Atmega328PP/5V-MAX-V-CPLD-breakout/Bill of Materials.txt

Bill of Materials:
MAX V 5M40Z EQFP 5V breakout board materials

Supplier links provided will all be Digikey (with minor exceptions), do note however that other suppliers may have better deals

All unit prices are from the given supplier at the date of BOM creation (12/01/2025)

Level shifters:

TXS0108EPWR
	Quantity: 6
	Digikey link: https://www.digikey.com/en/products/detail/texas-instruments/TXS0108EPWR/1775302
	Current unit price:	1.52 USD
	Current price to order 6 units: 9.12 USD
	Notes: You could buy 10 from digikey for 11.08 USD currently

CPLD:

5M40ZE64C5N
	Quantity: 1
	Digikey link: https://www.digikey.com/en/products/detail/altera/5M40ZE64C5N/2499440
	Current unit price: 1.26 USD
	Notes: All MAX V 5M40Z CPLDs are electrically pin swappable and each can be subtituted for one another

Voltage Converters:

TPSM828212 (5v to 1.8v)
	Quantity: 1
	Digikey link: https://www.digikey.com/en/products/detail/texas-instruments/TPSM828212SILR/14124028
	Current unit price: 2.61 USD

TPSM828214SILR (5v to 3.3v)
	Quantity: 1
	Digikey link: https://www.digikey.com/en/products/detail/texas-instruments/TPSM828214SILR/14124001
	Current unit price: 2.61 USD

JTAG header:

Generic 5x2 IDC male header
	Quantity: 1
	Digikey link: https://www.digikey.com/en/products/detail/on-shore-technology-inc/302-S101/2178422
	Current unit price: 0.26 USD

Board primary headers:

	Generic 1x27 2.54mm pitch male headers
	Quantity: 2
	Amazon link: https://www.amazon.com/Pin-Header-Connector-Breadboard-Connectors/dp/B0DSJD6TDR
	Current price for pack of 12 40 pin headers: 4.39 USD
	Notes: This is obviously VERY generic, and these headers can be broken into the ideal size, so I recommend that you find the best deal for a pack of them.

Capacitors:

10μF 0805:
	Quantity: 1
	Digikey link: https://www.digikey.com/en/products/detail/samsung-electro-mechanics/CL21A106KOQNNNE/3886754
	Current unit price: 0.08 USD

.01μF 0805:
	Quantity: 20
	Digikey link: https://www.digikey.com/en/products/detail/yageo/CC0805KRX7R9BB104/302874
	Current unit price: 0.08 USD
	Current price to order 20 units in cut-tape: 0.24 USD
	Notes: Ordering more than 10 reduces unit price to 0.012 USD

Resistors:

10kΩ 0805:
	Quantity: 2
	Digikey link: https://www.digikey.com/en/products/detail/vishay-dale/CRCW080510K0FKEA/1175751
	Current unit price: 0.1 USD
	Current price to order 2 units: 0.2 USD

1kΩ 0805:
	Quantity: 1
	Digikey link: https://www.digikey.com/en/products/detail/vishay-dale/CRCW08051K00FKEA/1175637
	Current unit price 0.1 USD
	
Total approximate price:

	16.48 USD excluding primary headers
	18.2 USD including male headers
	25-47 USD including PCB manufacturing (HIGHLY DEPENDANT ON MANUFACTURER)
