Atmega328PP/5V-MAX-V-CPLD-breakout/KiCAD files/CPLD breakout.kicad_pcb

## KiCad design KiCAD files/CPLD breakout.kicad_pcb (2025-12-01)

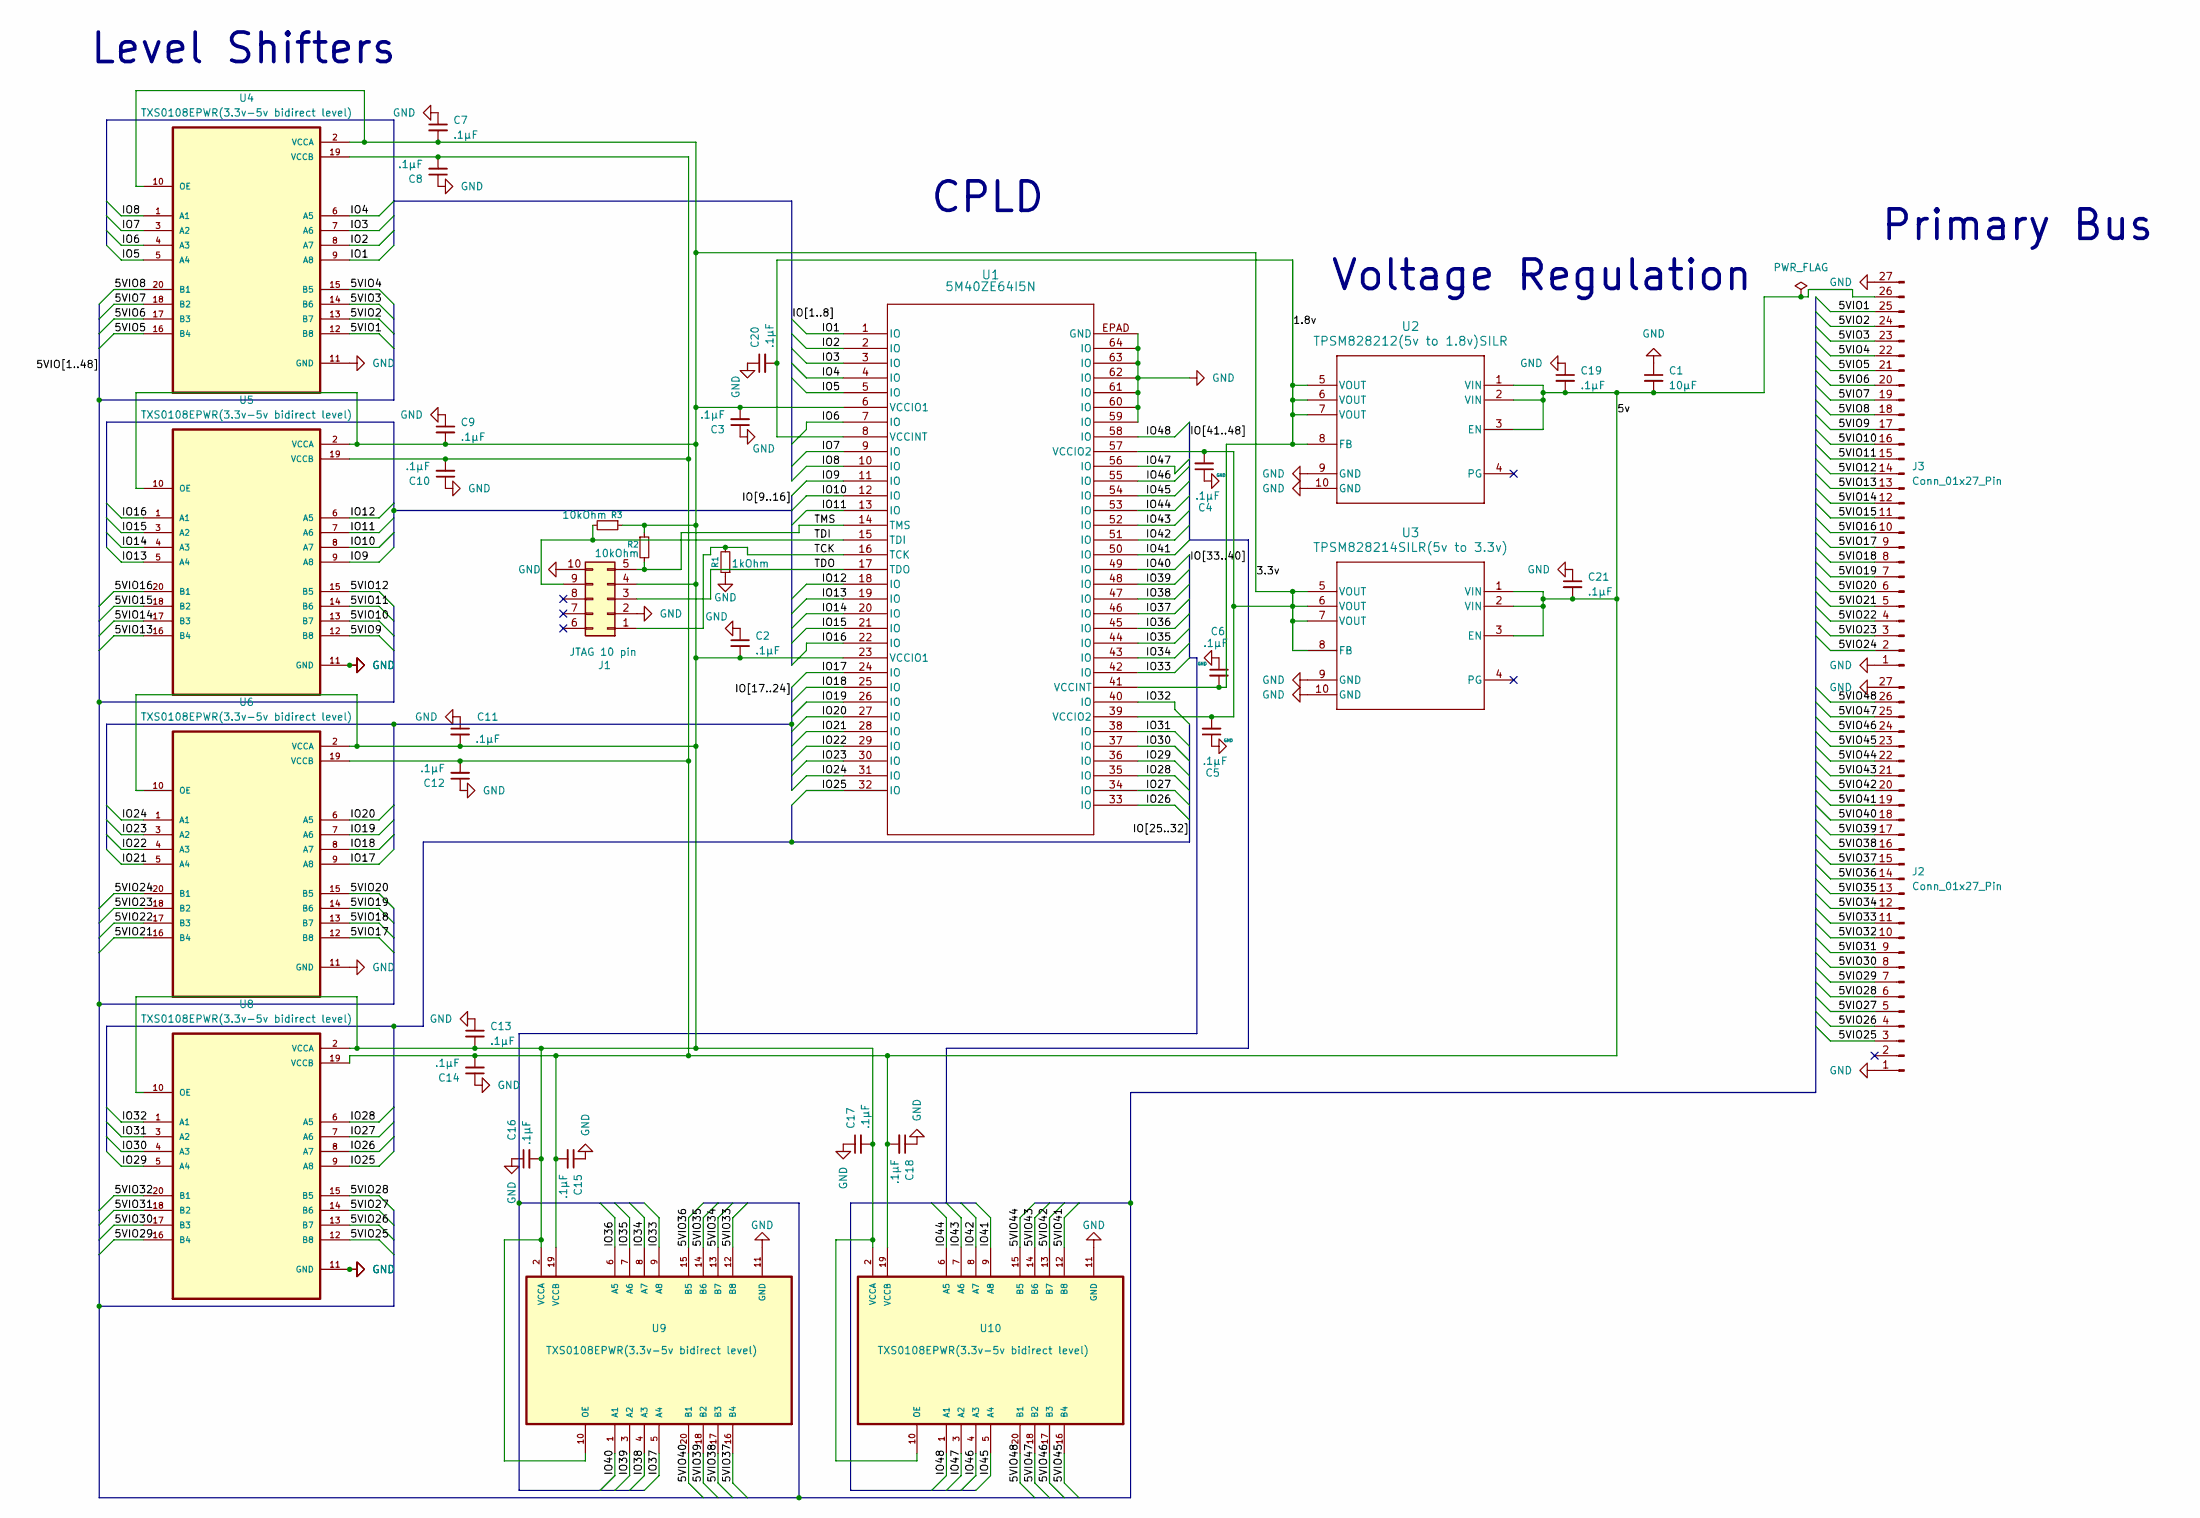
[picture p1: schematic CPLD breakout.kicad_sch, Altera CPLD 5M40Z 5v breakout]

Parts:
C1: 10μF; C_0805_2012Metric
C2, C3, C4, C5, C6, C7, C8, C9, C10, C11, C12, C13, C14, C15, C16, C17, C18, C19, C20, C21: .1μF; C_0805_2012Metric
J1: JTAG 10 pin; IDC-Header_2x05_P2.54mm_Vertical
J2, J3: Conn_01x27_Pin; PinHeader_1x27_P2.54mm_Vertical
R1: 1kOhm; R_0805_2012Metric
R2, R3: 10kOhm; R_0805_2012Metric
U1: 5M40ZE64I5N; EQFP64_A_1P2-D2_4P5_INT
U2: TPSM828212(5v to 1.8v)SILR; TPSM828212SILR(5v to 1.8v)
U3: TPSM828214SILR(5v to 3.3v)
U4, U5, U6, U8, U9, U10: TXS0108EPWR(3.3v-5v bidirect level); SOP65P640X120-20N(3.3v-5v bidirect shift)

Connections:
/1.8v: C6.2, C20.2, U1.8 (VCCINT), U1.41 (VCCINT), U2.5 (VOUT), U2.6 (VOUT), U2.7 (VOUT), U2.8 (FB)
/3.3v: C2.2, C3.2, C4.2, C5.2, C7.2, C9.2, C11.2, C13.2, C16.2, C17.2, J1.4, R2.1, R3.1, U1.6 (VCCIO1), U1.23 (VCCIO1), U1.39 (VCCIO2), U1.57 (VCCIO2), U3.5 (VOUT), U3.6 (VOUT), U3.7 (VOUT), U3.8 (FB), U4.2 (VCCA), U4.10 (OE), U5.2 (VCCA), U5.10 (OE), U6.2 (VCCA), U6.10 (OE), U8.2 (VCCA), U8.10 (OE), U9.2 (VCCA), U9.10 (OE), U10.2 (VCCA), U10.10 (OE)
/5VIO1: J3.25, U4.12 (B8)
/5VIO2: J3.24, U4.13 (B7)
/5VIO3: J3.23, U4.14 (B6)
/5VIO4: J3.22, U4.15 (B5)
/5VIO5: J3.21, U4.16 (B4)
/5VIO6: J3.20, U4.17 (B3)
/5VIO7: J3.19, U4.18 (B2)
/5VIO8: J3.18, U4.20 (B1)
/5VIO9: J3.17, U5.12 (B8)
/5VIO10: J3.16, U5.13 (B7)
/5VIO11: J3.15, U5.14 (B6)
/5VIO12: J3.14, U5.15 (B5)
/5VIO13: J3.13, U5.16 (B4)
/5VIO14: J3.12, U5.17 (B3)
/5VIO15: J3.11, U5.18 (B2)
/5VIO16: J3.10, U5.20 (B1)
/5VIO17: J3.9, U6.12 (B8)
/5VIO18: J3.8, U6.13 (B7)
/5VIO19: J3.7, U6.14 (B6)
/5VIO20: J3.6, U6.15 (B5)
/5VIO21: J3.5, U6.16 (B4)
/5VIO22: J3.4, U6.17 (B3)
/5VIO23: J3.3, U6.18 (B2)
/5VIO24: J3.2, U6.20 (B1)
/5VIO25: J2.3, U8.12 (B8)
/5VIO26: J2.4, U8.13 (B7)
/5VIO27: J2.5, U8.14 (B6)
/5VIO28: J2.6, U8.15 (B5)
/5VIO29: J2.7, U8.16 (B4)
/5VIO30: J2.8, U8.17 (B3)
/5VIO31: J2.9, U8.18 (B2)
/5VIO32: J2.10, U8.20 (B1)
/5VIO33: J2.11, U9.12 (B8)
/5VIO34: J2.12, U9.13 (B7)
/5VIO35: J2.13, U9.14 (B6)
/5VIO36: J2.14, U9.15 (B5)
/5VIO37: J2.15, U9.16 (B4)
/5VIO38: J2.16, U9.17 (B3)
/5VIO39: J2.17, U9.18 (B2)
/5VIO40: J2.18, U9.20 (B1)
/5VIO41: J2.19, U10.12 (B8)
/5VIO42: J2.20, U10.13 (B7)
/5VIO43: J2.21, U10.14 (B6)
/5VIO44: J2.22, U10.15 (B5)
/5VIO45: J2.23, U10.16 (B4)
/5VIO46: J2.24, U10.17 (B3)
/5VIO47: J2.25, U10.18 (B2)
/5VIO48: J2.26, U10.20 (B1)
/5v: C1.2, C8.2, C10.2, C12.2, C14.2, C15.2, C18.2, C19.2, C21.2, J3.26, U2.1 (VIN), U2.2 (VIN), U2.3 (EN), U3.1 (VIN), U3.2 (VIN), U3.3 (EN), U4.19 (VCCB), U5.19 (VCCB), U6.19 (VCCB), U8.19 (VCCB), U9.19 (VCCB), U10.19 (VCCB)
/IO1: U1.1 (IO), U4.9 (A8)
/IO2: U1.2 (IO), U4.8 (A7)
/IO3: U1.3 (IO), U4.7 (A6)
/IO4: U1.4 (IO), U4.6 (A5)
/IO5: U1.5 (IO), U4.5 (A4)
/IO6: U1.7 (IO), U4.4 (A3)
/IO7: U1.9 (IO), U4.3 (A2)
/IO8: U1.10 (IO), U4.1 (A1)
/IO9: U1.11 (IO), U5.9 (A8)
/IO10: U1.12 (IO), U5.8 (A7)
/IO11: U1.13 (IO), U5.7 (A6)
/IO12: U1.18 (IO), U5.6 (A5)
/IO13: U1.19 (IO), U5.5 (A4)
/IO14: U1.20 (IO), U5.4 (A3)
/IO15: U1.21 (IO), U5.3 (A2)
/IO16: U1.22 (IO), U5.1 (A1)
/IO17: U1.24 (IO), U6.9 (A8)
/IO18: U1.25 (IO), U6.8 (A7)
/IO19: U1.26 (IO), U6.7 (A6)
/IO20: U1.27 (IO), U6.6 (A5)
/IO21: U1.28 (IO), U6.5 (A4)
/IO22: U1.29 (IO), U6.4 (A3)
/IO23: U1.30 (IO), U6.3 (A2)
/IO24: U1.31 (IO), U6.1 (A1)
/IO25: U1.32 (IO), U8.9 (A8)
/IO26: U1.33 (IO), U8.8 (A7)
/IO27: U1.34 (IO), U8.7 (A6)
/IO28: U1.35 (IO), U8.6 (A5)
/IO29: U1.36 (IO), U8.5 (A4)
/IO30: U1.37 (IO), U8.4 (A3)
/IO31: U1.38 (IO), U8.3 (A2)
/IO32: U1.40 (IO), U8.1 (A1)
/IO33: U1.42 (IO), U9.9 (A8)
/IO34: U1.43 (IO), U9.8 (A7)
/IO35: U1.44 (IO), U9.7 (A6)
/IO36: U1.45 (IO), U9.6 (A5)
/IO37: U1.46 (IO), U9.5 (A4)
/IO38: U1.47 (IO), U9.4 (A3)
/IO39: U1.48 (IO), U9.3 (A2)
/IO40: U1.49 (IO), U9.1 (A1)
/IO41: U1.50 (IO), U10.9 (A8)
/IO42: U1.51 (IO), U10.8 (A7)
/IO43: U1.52 (IO), U10.7 (A6)
/IO44: U1.53 (IO), U10.6 (A5)
/IO45: U1.54 (IO), U10.5 (A4)
/IO46: U1.55 (IO), U10.4 (A3)
/IO47: U1.56 (IO), U10.3 (A2)
/IO48: U1.58 (IO), U10.1 (A1)
/TCK: J1.1, R1.2, U1.16 (TCK)
/TDI: J1.9, R3.2, U1.15 (TDI)
/TDO: J1.3, U1.17 (TDO)
/TMS: J1.5, R2.2, U1.14 (TMS)
GND: C1.1, C2.1, C3.1, C4.1, C5.1, C6.1, C7.1, C8.1, C9.1, C10.1, C11.1, C12.1, C13.1, C14.1, C15.1, C16.1, C17.1, C18.1, C19.1, C20.1, C21.1, J1.2, J1.10, J2.1, J2.27, J3.1, J3.27, R1.1, U1.59 (IO), U1.60 (IO), U1.61 (IO), U1.62 (IO), U1.63 (IO), U1.64 (IO), U1.EPAD (GND), U2.9 (GND), U2.10 (GND), U3.9 (GND), U3.10 (GND), U4.11 (GND), U5.11 (GND), U6.11 (GND), U8.11 (GND), U9.11 (GND), U10.11 (GND)

Notes on the sheet:
CPLD
Level Shifters
Voltage Regulation
Primary Bus

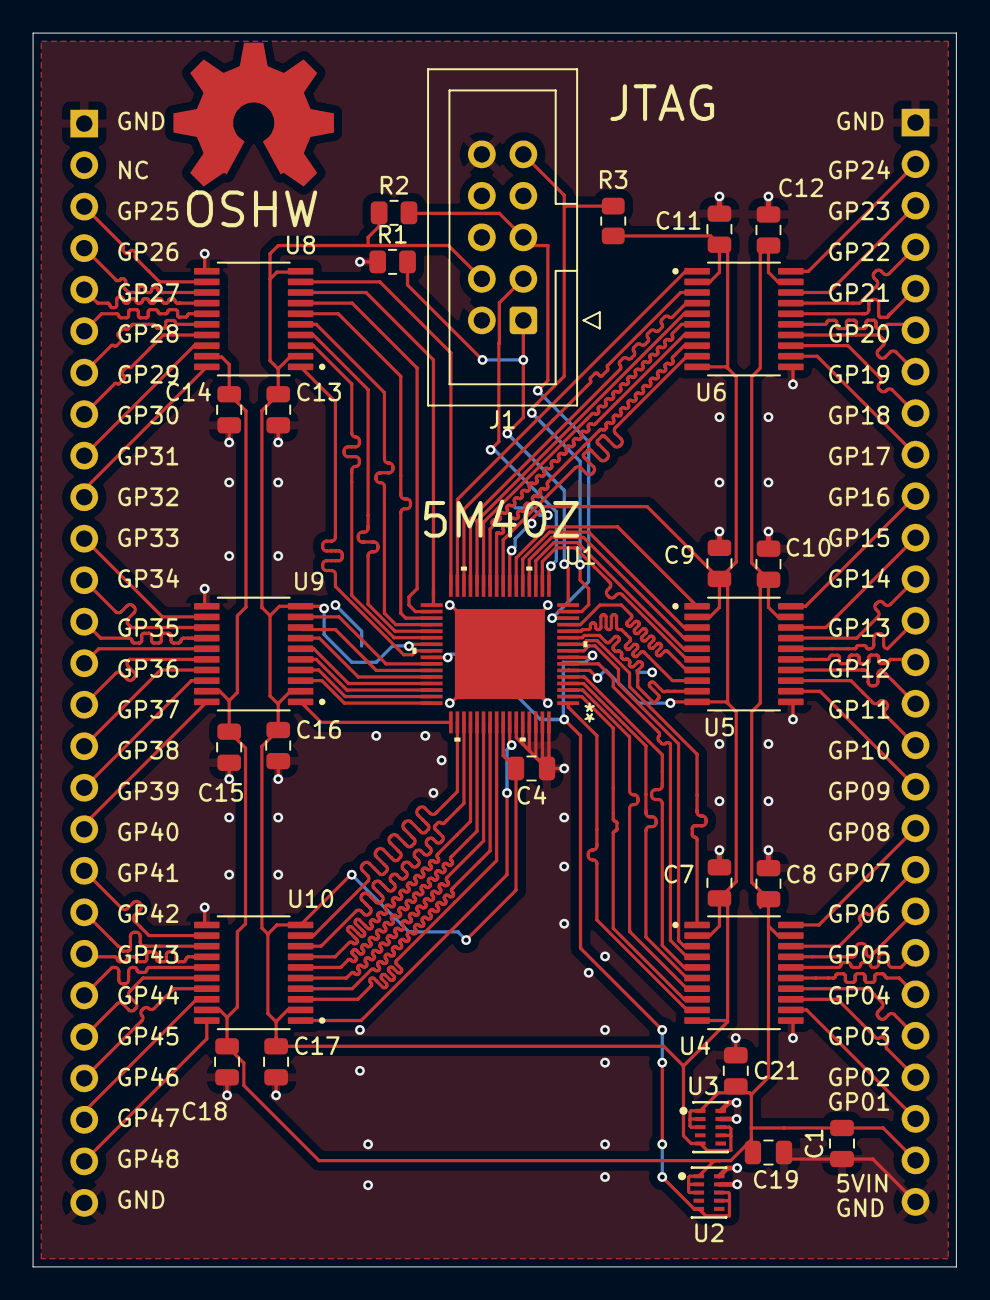
[picture p2: board CPLD breakout.kicad_pcb from above]

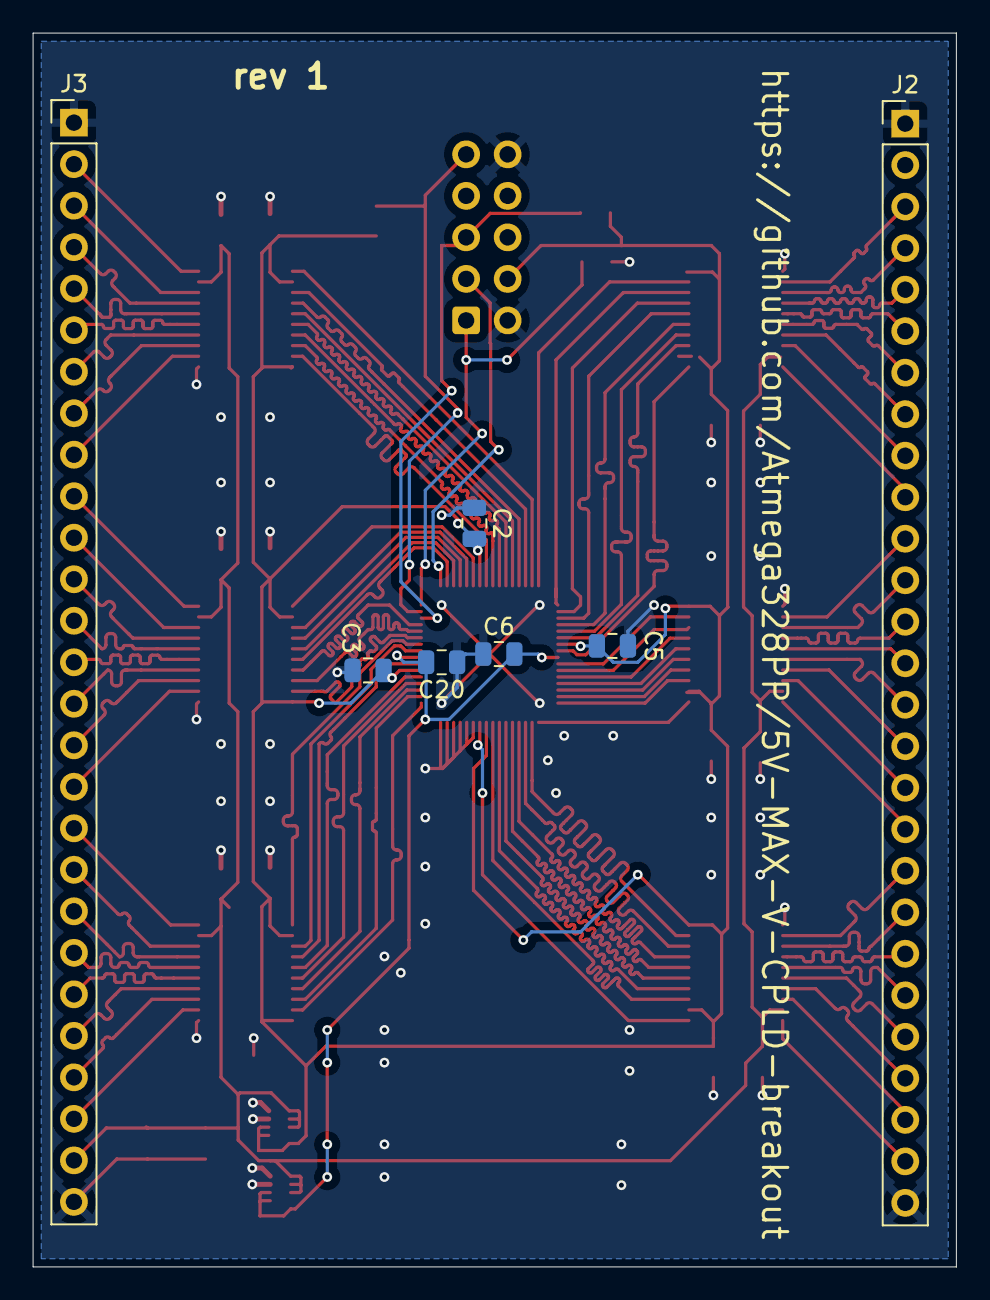
[picture p3: board CPLD breakout.kicad_pcb from below]

Board: 2 copper layers, 56.5 x 75.5 mm, 37 parts (7 on the bottom side), 104 nets.

Other parts of the board:
OSHW_COPPER_10MM: VAL**; OSHW_COPPER_10MM
