Atmega328PP/5V-MAX-V-CPLD-breakout/(commit log)

2025-12-01 Uploading new board and drill files
    Added "rev 1" to the bottom silkscreen and generated the new corresponding gerber drill files in a .zip
    [CPLD breakout.kicad_pcb, CPLD breakout.kicad_sch]
2025-12-01 Added Bill of Materials
2025-12-01 Rename Bill of Materials.md to Bill of Materials.txt
2025-12-02 Update Bill of Materials.txt
